bgunebakan/isimud/README.md

# Isimud
Sattellite modem control software and web application

# v2
Isimud v2 created with JAVA and Netbeans 8.0.2

# Libraries
 - Commons Cli 1.2
 - Pi4j
