bgunebakan/isimud/electronics/datasheets/simcard holder dimensions.jpg

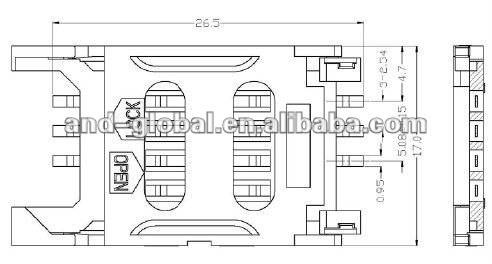
electronics/datasheets/simcard holder dimensions.jpg
