bgunebakan/isimud/electronics/datasheets/thuraya module.jpg

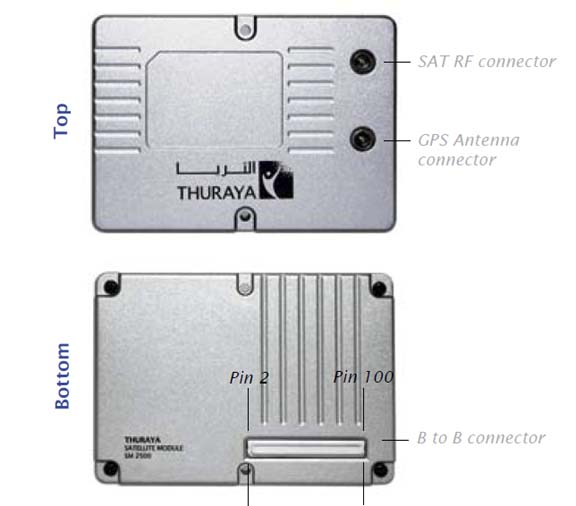
electronics/datasheets/thuraya module.jpg
