bgunebakan/isimud/screenshot/isimud_htop.png

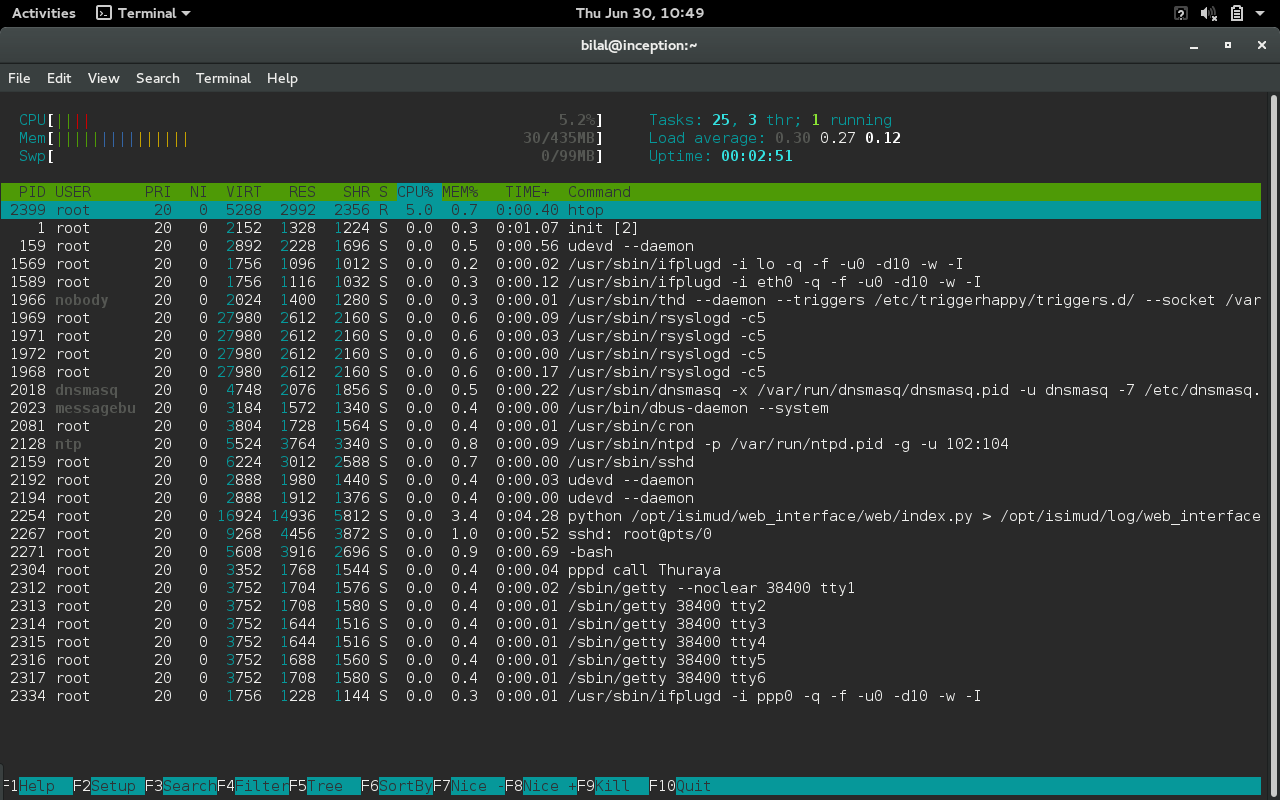
screenshot/isimud_htop.png
