bgunebakan/isimud/screenshot/isimud_web_interface.png

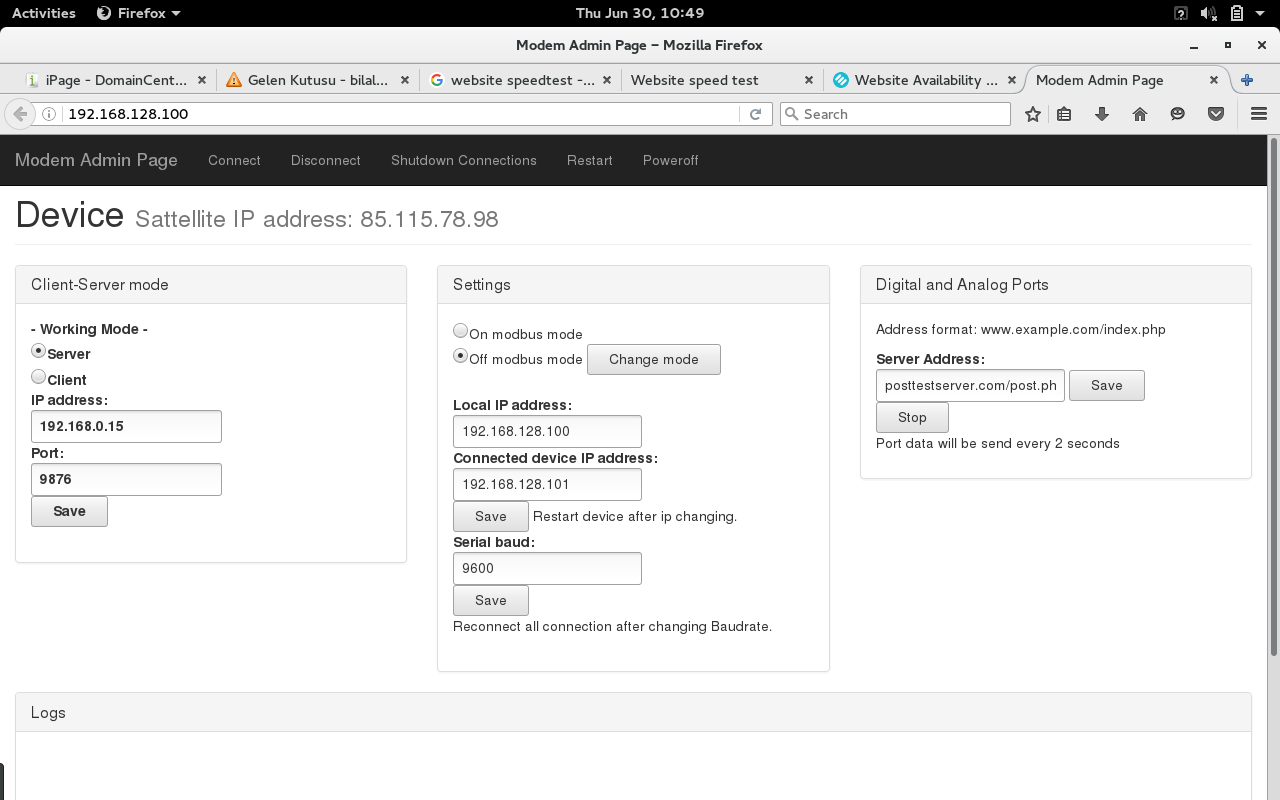
screenshot/isimud_web_interface.png
