bgunebakan/isimud/mechanics/Isimud.SLDASM

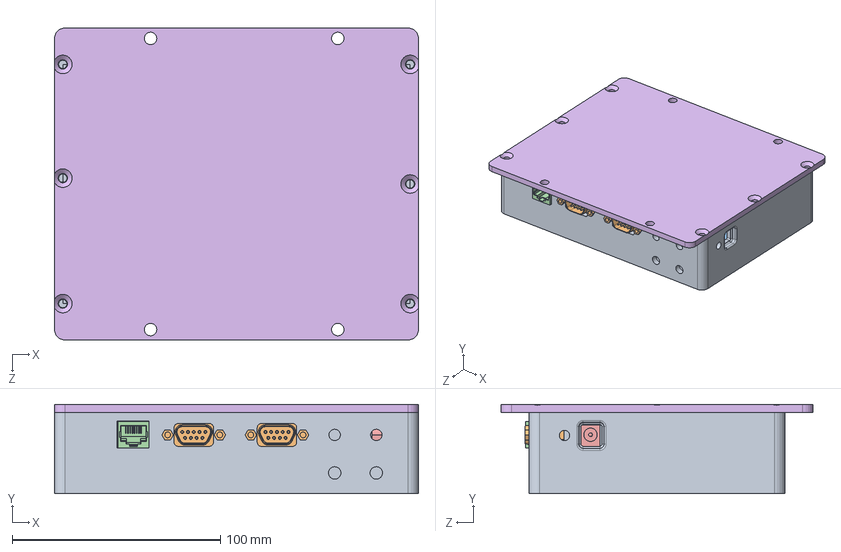
[picture p5: CAD file, 2016-08-03]
mechanics/Isimud.SLDASM
175.0 x 43.0 x 150.0 mm
bottom cover
DB9RA_M x 2
main board pcb
RJ-45
power jack
top cover
