bgunebakan/isimud/mechanics/electronics/main board pcb.SLDPRT

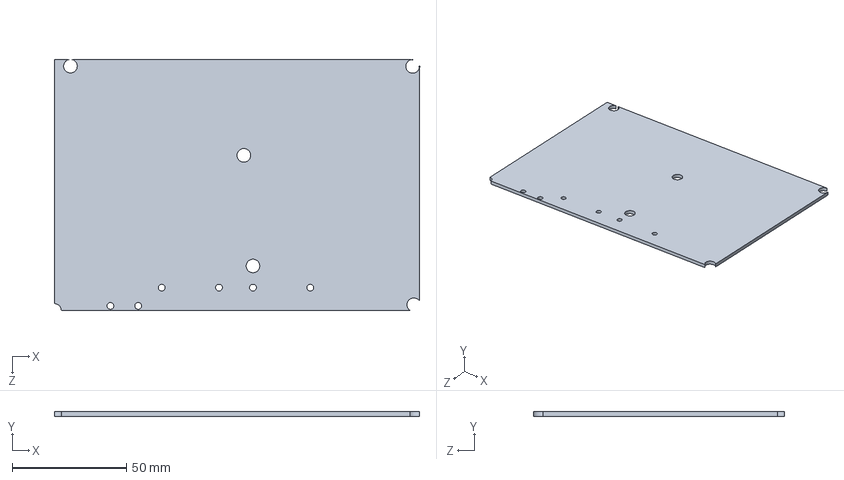
[picture p6: CAD file, 2016-07-28]
mechanics/electronics/main board pcb.SLDPRT
160.0 x 2.00 x 110.0 mm
