bgunebakan/isimud/mechanics/3d printed/top cover.SLDPRT

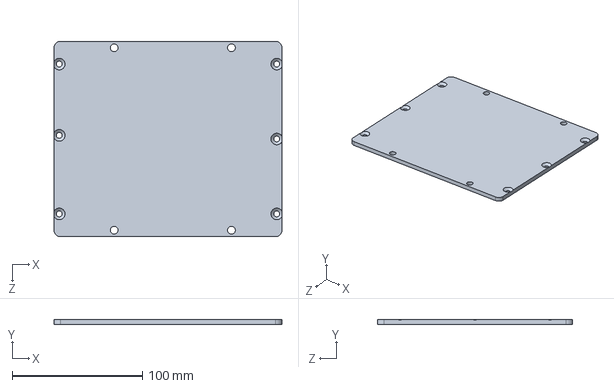
[picture p7: CAD file, 2016-08-03]
mechanics/3d printed/top cover.SLDPRT
175.0 x 4.00 x 150.0 mm
