bgunebakan/isimud/mechanics/electronics/RJ-45.SLDPRT

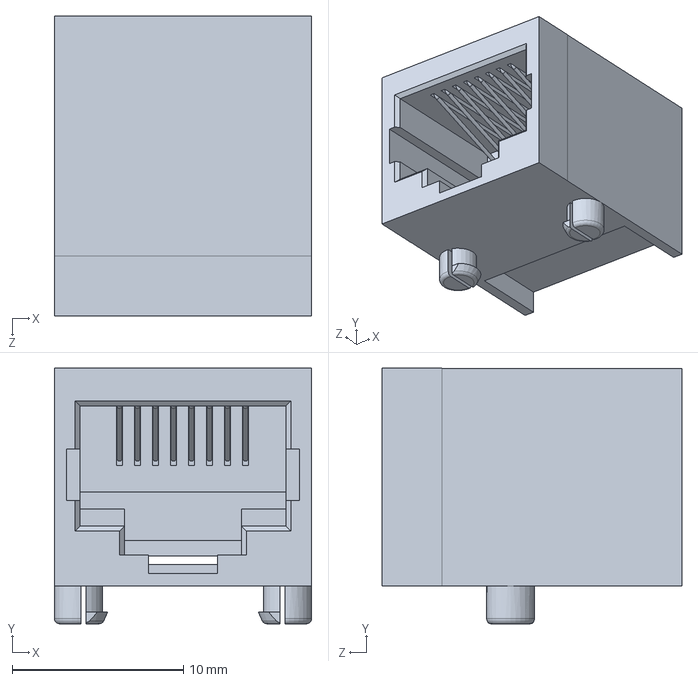
[picture p8: CAD file, 2016-07-28]
mechanics/electronics/RJ-45.SLDPRT
15.0 x 14.9 x 17.5 mm
