bgunebakan/isimud/mechanics/3d printed/bottom cover.SLDPRT

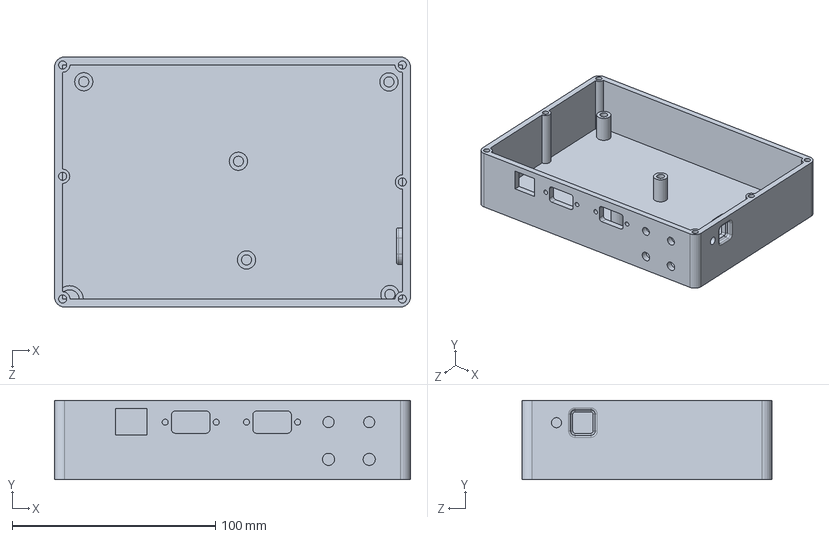
[picture p9: CAD file, 2016-07-28]
mechanics/3d printed/bottom cover.SLDPRT
175.0 x 39.0 x 123.0 mm
