bgunebakan/isimud/mechanics/electronics/DB9RA_M.SLDPRT

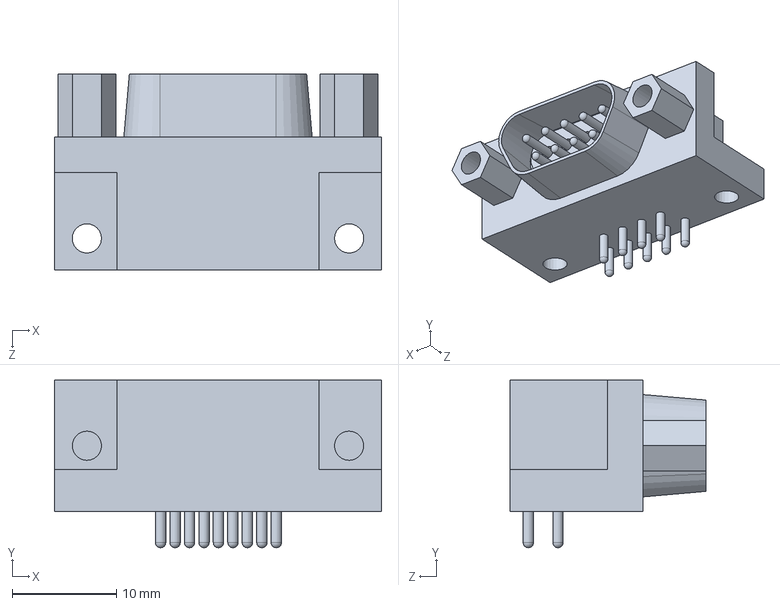
[picture p10: CAD file, 2016-07-28]
mechanics/electronics/DB9RA_M.SLDPRT
31.3 x 16.1 x 18.8 mm
