bgunebakan/isimud/mechanics/electronics/power jack.SLDPRT

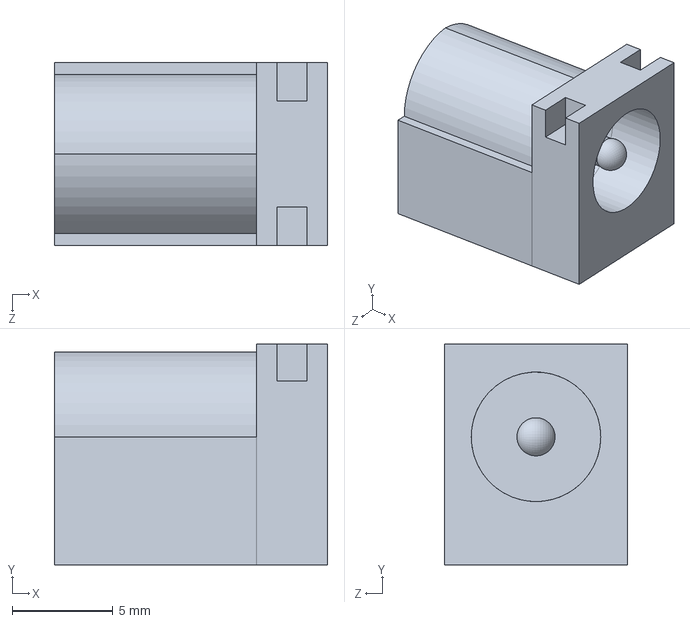
[picture p11: CAD file, 2016-07-28]
mechanics/electronics/power jack.SLDPRT
13.5 x 10.9 x 9.07 mm
