bgunebakan/isimud/(list of files, cad)

Other CAD files:
mechanics/3d printed/bottom cover.STL
mechanics/3d printed/top cover.STL
mechanics/electronics/RJ45.SLDPRT
