bgunebakan/isimud/(list of files, drawings)

Other design files:
electronics/datasheets/Scout/bll.DSN
electronics/datasheets/Scout/PHONE.LYT
electronics/gigabit ethernet/ext-ethernet.dsn
electronics/isimud_main/isimud_main.dsn
