bgunebakan/isimud/electronics/isimud_main/isimud_main.kicad_pcb

## KiCad design electronics/isimud_main/isimud_main.kicad_pcb (2017-01-13)

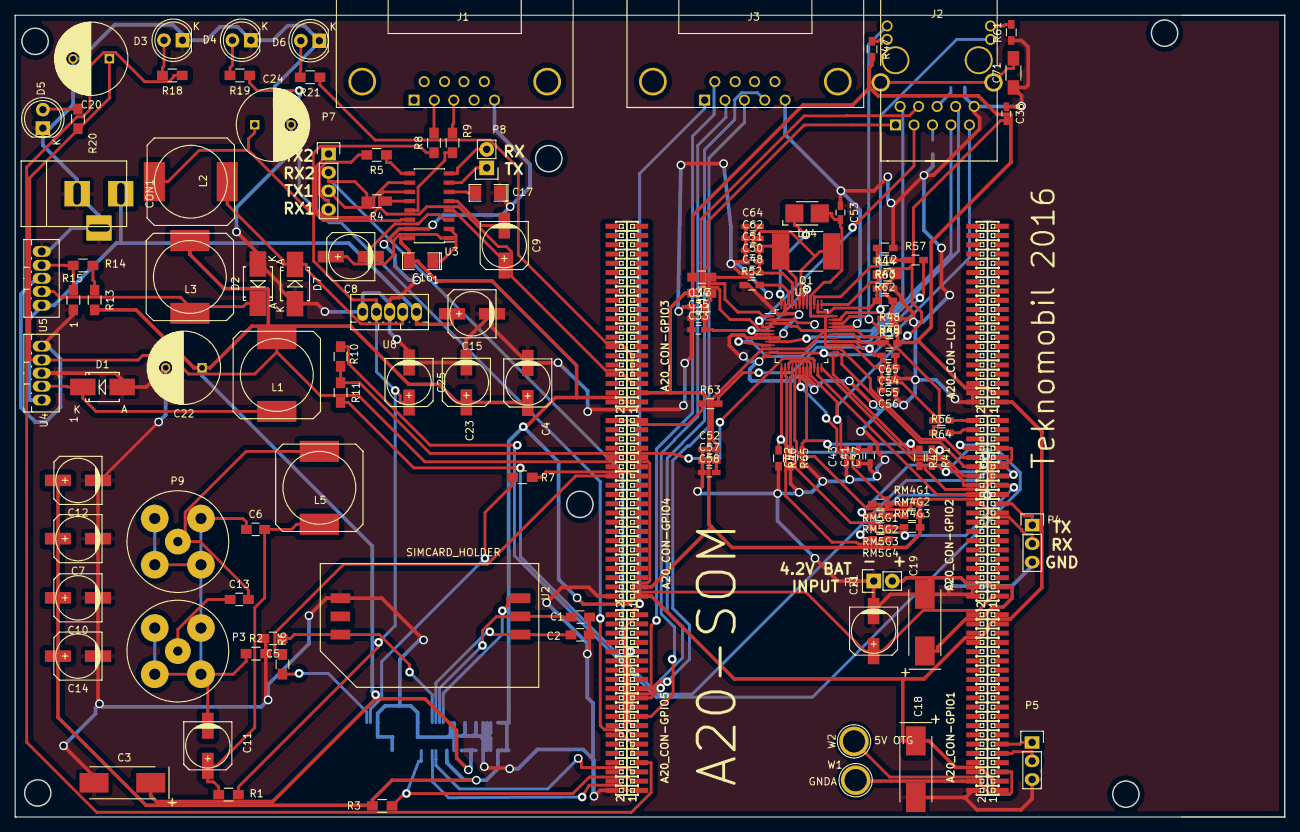
[picture p12: board isimud_main.kicad_pcb from above]

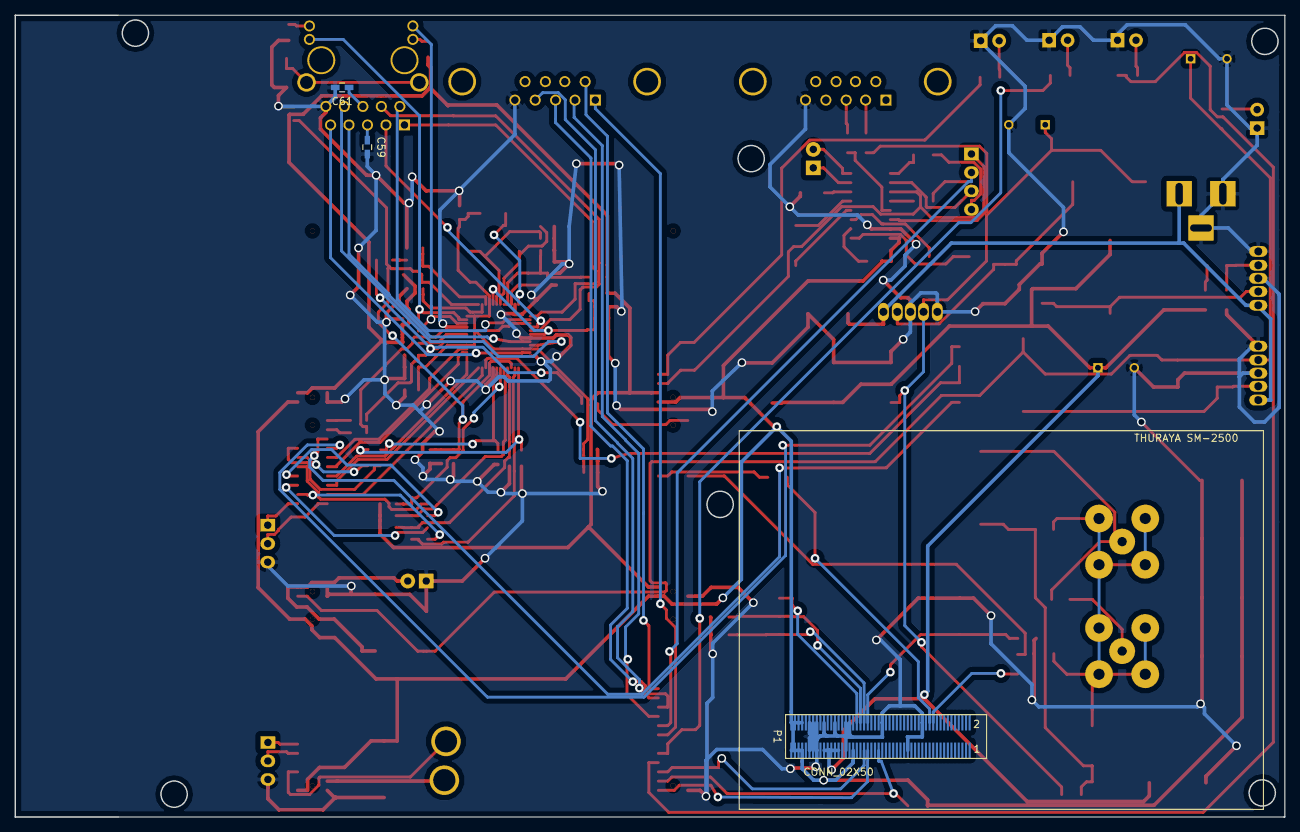
[picture p13: board isimud_main.kicad_pcb from below]

Board: 2 copper layers, 174.4 x 110.1 mm, 129 parts (3 on the bottom side), 115 nets.

Parts:
C1, C2, C5: 33pF; C_0805_HandSoldering
C3: 33uF 16V; TantalC_SizeD_EIA-7343_HandSoldering
C4: 1uF 16V; c_elec_6.3x5.8
C6, C13: 100nF; C_0805_HandSoldering
C7, C10, C11, C12, C14: 47uF 16V; c_elec_6.3x5.8
C8, C9: 1uF; c_elec_6.3x5.8
C15: 100uF; c_elec_6.3x5.8
C16, C17: 1uF; SMD-1206_Pol
C18: 10uF; TantalC_SizeD_EIA-7343_HandSoldering
C19: 22uF 6.3v; TantalC_SizeD_EIA-7343_HandSoldering
C20, C22, C24: 1000uF 16V; C_Radial_D10_L16_P5
C21, C23, C25: 220uF 16V; c_elec_6.3x5.8
C33, C37, C48, C52, C53: 22uF/6.3V; C_0603_HandSoldering
C34, C35, C38, C41, C43, C50, C51, C54, C55, C56, C57, C58, C59, C61: 100nF; C_0603_HandSoldering
C42, C65: NA; C_0603_HandSoldering
C62, C64: 27pF; C_0603_HandSoldering
C71: 1nF/2kV/X7R/1206; C_1206_HandSoldering
CON1: 12V DC; BARREL_JACK
D1, D2, D7: 1N5822; SMB_Handsoldering
D3: SAT_ON; LED-5MM
D4: GPS_ON; LED-5MM
D5: PWR_ON; LED-5MM
D6: STATUS; LED-5MM
J1, J3: DB9; DB9FC
J2: TM211Q01FM22
L1, L2, L3, L5: 100uH; SELF-WE-PD-XXL
L11, L12, L13: FB0805/600R/2A; C_0805_HandSoldering
L14: 4.7uH/1.15A/DCR<0.1R/CD43; Inductor_1212
P1: CONN_02X50; BB-2X50-SMD
P2: LIPO_BAT; Socket_Strip_Straight_1x02
P3: SAT MODULE GPS; bnc-ci
P4: UART_0; Pin_Header_Straight_1x03
P5: UART_4; Pin_Header_Straight_1x03
P7: RS232-UART; Pin_Header_Straight_1x04
P8: RS232-2; Pin_Header_Straight_1x02
P9: AKTIF GPS ANTEN; bnc-ci
Q1: E4SB25.000F20E15(25MHz/20pF/20ppm/5x3.2mm); C_2220_HandSoldering
R1, R2, R8, R9, R11: 0R; R_0805_HandSoldering
R3: 10k; R_0805_HandSoldering
R4, R5: 2k2; R_0805_HandSoldering
R6, R7: 330; R_0805_HandSoldering
R10: NA; R_0805_HandSoldering
R13, R14: 1k2; R_0805_HandSoldering
R15: 1k; R_0805_HandSoldering
R18, R19, R20, R21: 220R; R_0805_HandSoldering
R40: 10K; R_0603_HandSoldering
R41, R42, R66: 22R; R_0603_HandSoldering
R43: 10k; R_0603_HandSoldering
R44, R57, R60, R64: NA; R_0603_HandSoldering
R47, R49, R61: 1K; R_0603_HandSoldering
R48, R59, R62: 4K7; R_0603_HandSoldering
R52: 2.49k/1%; R_0603_HandSoldering
R63: 1k; R_0603_HandSoldering
R65: NA(4.7k); R_0603_HandSoldering
RM4G1, RM4G2, RM4G3: R; R_0603_HandSoldering
RM5G1, RM5G2, RM5G3, RM5G4: RA1206_(4X0603)_4B8_22R; R_0603_HandSoldering
U1: SOM-A20; A20-SOM
U2: SIMCARD_HOLDER; SIMCARD
U3: MAX232; SOIC-16_3.9x9.9mm_Pitch1.27mm
U4, U8: LM2576-5V; Pentawatt_Neutral_Straight_Vertical_TO220-5-T05A
U5: LM2576; Pentawatt_Neutral_Straight_Vertical_TO220-5-T05A
U7: RTL8211CL-GR; LQFP-48_7x7mm_Pitch0.5mm
W1: GNDA; 1pin
W2: 5V OTG; 1pin

Connections:
+3V3: L11.2, L12.2, L13.2, R47.2, R48.2, R49.2, R62.2, RM4G1.2, RM4G2.2, RM4G3.2, U1.3-3, U1.4-3, U1.6-3
+5V: C7.1, C10.1, C12.1, C14.1, C16.2, C18.1, P1.65, P1.93, P1.94, P1.95, P1.96, P1.97, P1.98, P1.99, P1.100, R3.2, U1.1-1, U1.3-1, U1.4-1, U1.6-1, U3.16
+5VD: C24.1, C25.1, L2.2, R1.2, U8.4
+6V: C3.1, C4.1, C22.1, C23.1, L3.2, P1.73, P1.75, P1.77, P1.79, P1.81, R13.2
+12V: C15.1, CON1.1, U4.1, U5.1, U8.1
+BATT: C19.1, P2.2, U1.2-3
/THURAYA_RX: P1.24, R7.2
/THURAYA_TX: P1.22, R6.2
CLK125: R66.2, U1.2-38
EMDIO: R49.1, U7.31
EPHY-RST#: R64.1, U1.2-40
ERXCK: R42.2, U1.2-33
ERXD0: RM5G4.2, U1.2-23
ERXD1: RM5G3.2, U1.2-25
ERXD2: RM5G2.2, U1.2-27
ERXD3: RM5G1.2, U1.2-29
ERXDV: R41.2, U1.2-31
ETXCK: R10.1, R11.1, U7.22
ETXD0: U1.2-24, U7.23
ETXD1: U1.2-26, U7.24
ETXD2: U1.2-28, U7.25
ETXD3: U1.2-30, U7.26
ETXEN: U1.2-32, U7.27
GND: C1.2, C2.2, C3.2, C4.2, C5.2, C7.2, C10.2, C12.2, C14.2, C15.2, C17.1, C18.2, C19.2, C20.2, C21.2, C22.2, C23.2, C24.2, C25.2, C33.1, C34.1, C35.1, C37.1, C38.1, C41.1, C42.1, C43.1, C48.1, C50.1, C51.1, C52.1, C53.1, C54.1, C55.1, C56.1, C57.1, C58.1, C59.2, C61.2, C62.1, C64.1, C65.1, C71.1, CON1.2, CON1.3, D1.2, D2.2, D3.1, D4.1, D5.1, D6.1, D7.2, J1.5, J2.10, J3.5, P1.28, P1.35, P1.50, P1.67, P1.68, P1.69, P1.70, P1.76, P1.82, P1.83, P1.85, P1.86, P1.87, P1.88, P1.89, P1.90, P1.91, P1.92, P2.1, P4.3, P5.3, R2.2, R15.1, R40.2, R44.1, R52.1, R59.1, R60.2, R61.1, R65.2, U1.1-2, U1.2-2, U1.2-4, U1.4-2, U1.5-2, U1.6-2, U1.6-4, U2.4, U3.15, U4.3, U4.5, U5.3, U5.5, U7.7, U7.12, U7.20, U7.33, U7.47, U8.3, U8.5
GNDA: U1.1-4, W1.1
GPS_LED: R19.1, U1.5-9
unnamed: C1.1, P1.62, U2.2
unnamed: C2.1, P1.60, U2.3
unnamed: C5.1, P1.58, U2.6
unnamed: C8.1, U3.1
unnamed: C8.2, U3.3
unnamed: C9.1, U3.4
unnamed: C9.2, U3.5
unnamed: C6.2, C11.1, L5.1, R1.1
unnamed: C6.1, C11.2, P3.2, P9.2, R2.1
unnamed: C13.1, P3.1
unnamed: C13.2, L5.2, P9.1
unnamed: C16.1, U3.2
unnamed: C17.2, U3.6
unnamed: C33.2, C34.2, C35.2, L11.1, U7.6, U7.41
unnamed: C37.2, C38.2, C41.2, C43.2, L12.1, U7.15, U7.21, U7.37
unnamed: C42.2, R42.1, U7.19
unnamed: C48.2, C50.2, C51.2, L13.1, U7.44, U7.45
unnamed: C52.2, C53.2, C54.2, C55.2, C56.2, C57.2, C58.2, L14.2, U7.3, U7.10, U7.28, U7.36, U7.40
unnamed: C59.1, J2.5
unnamed: C61.1, J2.6
unnamed: C62.2, Q1.1, U7.42
unnamed: C64.2, Q1.2, U7.43
unnamed: C65.2, R57.2, R63.2, R64.2, U7.29
unnamed: C71.2, J2.SH1, J2.SH2
unnamed: D1.1, L1.1, U4.2
unnamed: D2.1, L3.1, U5.2
unnamed: D3.2, R18.2
unnamed: D4.2, R19.2
unnamed: D5.2, R20.2
unnamed: D6.2, R21.2
unnamed: D7.1, L2.1, U8.2
unnamed: J1.2, R8.2
unnamed: J1.3, R9.2
unnamed: J2.1, U7.1
unnamed: J2.2, U7.2
unnamed: J2.3, U7.4
unnamed: J2.4, U7.5
unnamed: J2.7, U7.8
unnamed: J2.8, U7.9
unnamed: J2.9, U7.11
unnamed: J2.11, R59.2, U7.35
unnamed: J2.12, R61.2
unnamed: J2.13, R47.1
unnamed: J2.14, R48.1, U7.34
unnamed: L14.1, U7.48
unnamed: P1.64, U2.1
unnamed: P7.3, U3.10
unnamed: P7.4, R5.2
unnamed: P8.1, U3.7
unnamed: P8.2, U3.8
unnamed: R4.1, U3.12
unnamed: R5.1, U3.9
unnamed: R8.1, U3.14
unnamed: R9.1, U3.13
unnamed: R10.2, U1.2-34
unnamed: R11.2, U1.2-36
unnamed: R13.1, R14.1
unnamed: R14.2, R15.2, U5.4
unnamed: R40.1, R41.1, U7.13
unnamed: R43.1, R57.1
unnamed: R43.2, R44.2, U7.39
unnamed: R52.2, U7.46
unnamed: R60.1, R62.1, U7.38
unnamed: R65.1, RM4G3.1, RM5G3.1, U7.16
unnamed: R66.1, U7.32
unnamed: RM4G1.1, RM5G1.1, U7.18
unnamed: RM4G2.1, RM5G2.1, U7.17
unnamed: RM5G4.1, U7.14
unnamed: U1.1-5, W2.1
PG6: J3.1, U1.5-13
PG8: J3.2, U1.5-17
PG9: J3.3, U1.5-19
PG10: J3.4, U1.5-21
PG11: J3.6, U1.5-23
PWR_LED: C20.1, C21.1, L1.2, R20.1, U1.2-1, U4.4
RESET_N: R63.1, U1.4-40
SAT_LED: R18.1, U1.5-7
SAT_OFF: P1.59, U1.5-5
SAT_ON: P1.57, U1.5-1
SAT_RST: P1.51, R3.1, U1.5-3
STATUS_LED: R21.1, U1.3-7
UART0_RX: P4.2, U1.2-22
UART0_TX: P4.1, U1.2-21
UART3_RX: P7.2, R4.2, U1.5-15
UART3_TX: P7.1, U1.3-5, U3.11
UART4_RX: P5.2, U1.1-9
UART4_TX: P5.1, U1.1-11
UART6_RX: R6.1, U1.4-28
UART6_TX: R7.1, U1.4-27
