bgunebakan/isimud/electronics/gigabit ethernet/ext-ethernet.kicad_pcb

## KiCad design electronics/gigabit ethernet/ext-ethernet.kicad_pcb (2016-09-30)

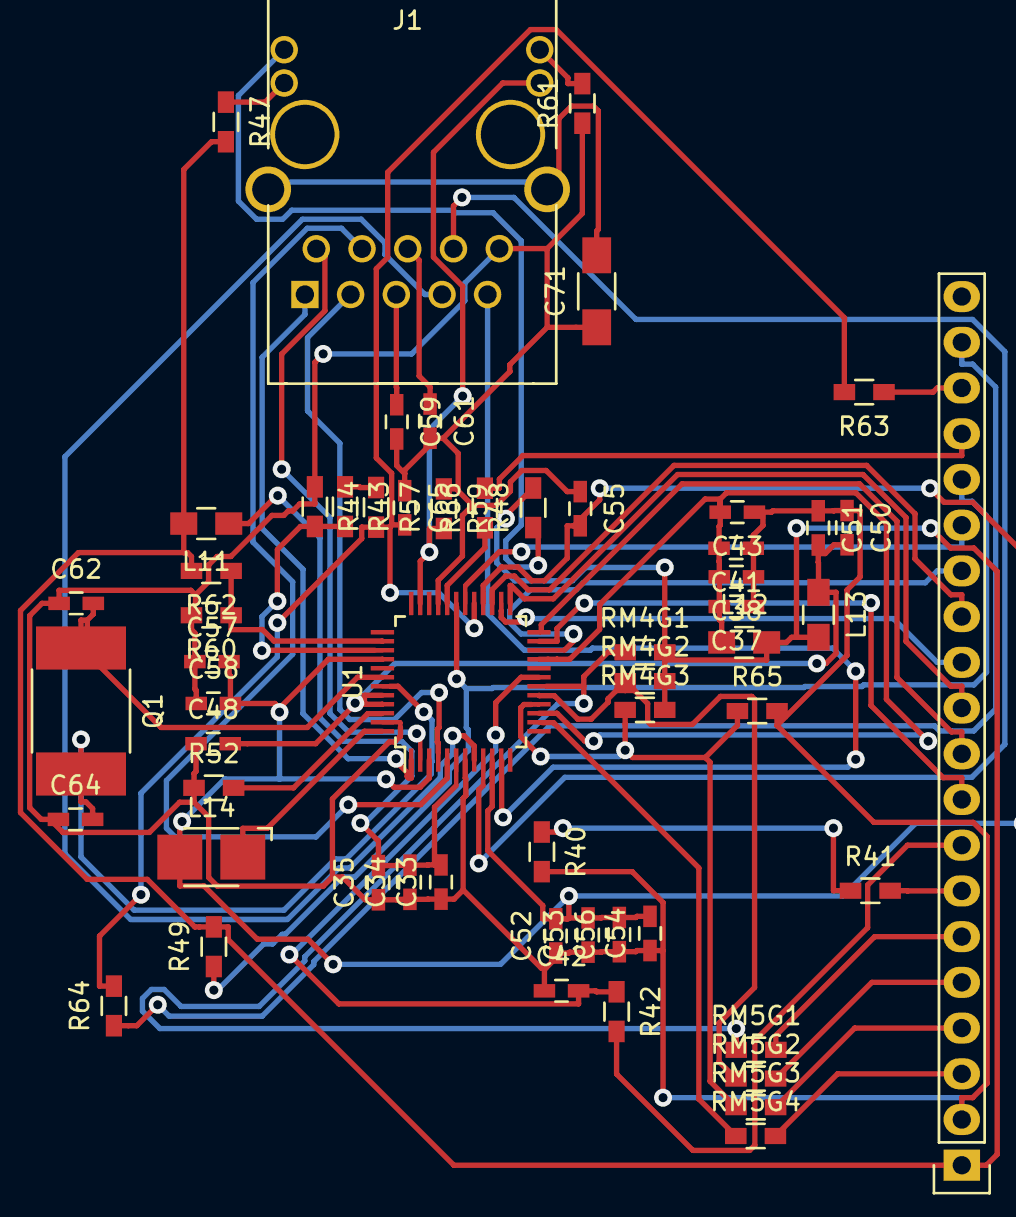
[picture p14: board ext-ethernet.kicad_pcb from above]

Board: 2 copper layers, 57 parts (0 on the bottom side), 52 nets.

Parts:
C33, C37, C48, C52, C53: 22uF/6.3V; C_0603_HandSoldering
C34, C35, C38, C41, C43, C50, C51, C54, C55, C56, C57, C58, C59, C61: 100nF; C_0603_HandSoldering
C42, C65: NA; C_0603_HandSoldering
C62, C64: 27pF; C_0603_HandSoldering
C71: 1nF/2kV/X7R/1206; C_1206_HandSoldering
J1: TM211Q01FM22
L11, L12, L13: FB0805/600R/2A; C_0805_HandSoldering
L14: 4.7uH/1.15A/DCR<0.1R/CD43; Inductor_1212
P1: CONN_01X20; Pin_Header_Straight_1x20
Q1: E4SB25.000F20E15(25MHz/20pF/20ppm/5x3.2mm); C_2220_HandSoldering
R40: 10K; R_0603_HandSoldering
R41, R42, R66: 22R; R_0603_HandSoldering
R43: 10k; R_0603_HandSoldering
R44, R57, R60, R64: NA; R_0603_HandSoldering
R47, R49, R61: 1K; R_0603_HandSoldering
R48, R59, R62: 4K7; R_0603_HandSoldering
R52: 2.49k/1%; R_0603_HandSoldering
R63: 1k; R_0603_HandSoldering
R65: NA(4.7k); R_0603_HandSoldering
RM4G1, RM4G2, RM4G3: R; R_0603_HandSoldering
RM5G1, RM5G2, RM5G3, RM5G4: RA1206_(4X0603)_4B8_22R; R_0603_HandSoldering
U1: RTL8211CL-GR; LQFP-48_7x7mm_Pitch0.5mm

Connections:
+3V3: L11.2, L12.2, L13.2, P1.1, R47.2, R48.2, R49.2, R62.2, RM4G1.2, RM4G2.2, RM4G3.2
GND: C33.1, C34.1, C35.1, C37.1, C38.1, C41.1, C42.1, C43.1, C48.1, C50.1, C51.1, C52.1, C53.1, C54.1, C55.1, C56.1, C57.1, C58.1, C59.2, C61.2, C62.1, C64.1, C65.1, C71.1, J1.10, P1.2, R40.2, R44.1, R52.1, R59.1, R60.2, R61.1, R65.2, U1.7, U1.12, U1.20, U1.33, U1.47
unnamed: C33.2, C34.2, C35.2, L11.1, U1.6, U1.41
unnamed: C37.2, C38.2, C41.2, C43.2, L12.1, U1.15, U1.21, U1.37
unnamed: C42.2, R42.1, U1.19
unnamed: C48.2, C50.2, C51.2, L13.1, U1.44, U1.45
unnamed: C52.2, C53.2, C54.2, C55.2, C56.2, C57.2, C58.2, L14.2, U1.3, U1.10, U1.28, U1.36, U1.40
unnamed: C59.1, J1.5
unnamed: C61.1, J1.6
unnamed: C62.2, Q1.1, U1.42
unnamed: C64.2, Q1.2, U1.43
unnamed: C65.2, R57.2, R63.2, R64.2, U1.29
unnamed: C71.2, J1.SH1, J1.SH2
unnamed: J1.1, U1.1
unnamed: J1.2, U1.2
unnamed: J1.3, U1.4
unnamed: J1.4, U1.5
unnamed: J1.7, U1.8
unnamed: J1.8, U1.9
unnamed: J1.9, U1.11
unnamed: J1.11, R59.2, U1.35
unnamed: J1.12, R61.2
unnamed: J1.13, R47.1
unnamed: J1.14, R48.1, U1.34
unnamed: L14.1, U1.48
unnamed: P1.3, RM5G4.2
unnamed: P1.4, RM5G3.2
unnamed: P1.5, RM5G2.2
unnamed: P1.6, RM5G1.2
unnamed: P1.7, R41.2
unnamed: P1.8, R42.2
unnamed: P1.9, U1.23
unnamed: P1.10, U1.24
unnamed: P1.11, U1.25
unnamed: P1.12, U1.26
unnamed: P1.13, U1.27
unnamed: P1.14, U1.22
unnamed: P1.15, U1.30
unnamed: P1.16, R49.1, U1.31
unnamed: P1.17, R66.2
unnamed: P1.18, R63.1
unnamed: P1.19, R64.1
unnamed: R40.1, R41.1, U1.13
unnamed: R43.1, R57.1
unnamed: R43.2, R44.2, U1.39
unnamed: R52.2, U1.46
unnamed: R60.1, R62.1, U1.38
unnamed: R65.1, RM4G3.1, RM5G3.1, U1.16
unnamed: R66.1, U1.32
unnamed: RM4G1.1, RM5G1.1, U1.18
unnamed: RM4G2.1, RM5G2.1, U1.17
unnamed: RM5G4.1, U1.14
