bgunebakan/isimud/software/isimud_v2/Isimud/src/isimud/Main.java

/*
 * Copyright (C) 2015 Bilal Tonga
 *
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
 * You should have received a copy of the GNU General Public License
 * along with this program; if not, write to the Free Software
 * Foundation, Inc., 59 Temple Place - Suite 330, Boston, MA  02111-1307, USA.
 */
package isimud;

/**
 *
 * @author gunebakan
 */
public class Main {

    /**
     * @param args the command line arguments
     */
    
    Config config = new Config();
    
    
    
    
    
    public static void main(String[] args) throws Exception {
        new Cli(args).parse();
        
        //tcp.startServer("123");
        //tcp.sendPost("http://ufakisler.net","lang=eng");
        
        
        
        
    }
    
}
