bgunebakan/isimud/software/isimud_v2/Isimud/src/isimud/Serial.java

/*
 * Copyright (C) 2015 gunebakan
 *
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
 * You should have received a copy of the GNU General Public License
 * along with this program; if not, write to the Free Software
 * Foundation, Inc., 59 Temple Place - Suite 330, Boston, MA  02111-1307, USA.
 */
package isimud;

import com.pi4j.io.serial.SerialPortException;
import java.util.Arrays;
import java.util.logging.Level;
import java.util.logging.Logger;
import jssc.SerialPort;
import jssc.SerialPortEvent;
import jssc.SerialPortEventListener;

/**
 *
 * @author gunebakan
 */
public class Serial {
    
    static SerialPort serialPort;
    String readSerialData;
    boolean bufferFull = false;
    
    Config config = new Config();
  // Tcp tcp = new Tcp();
    
    public void initSerial(){
        serialPort = new SerialPort(config.serial_port);
        
        try {
            System.out.println("Port opened: " + serialPort.openPort());
            System.out.println("Params setted: " + serialPort.setParams(9600, 8, 1, 0));
            
        }
        catch (SerialPortException ex){
            System.out.println(ex);
        } catch (jssc.SerialPortException ex) {
            Logger.getLogger(Serial.class.getName()).log(Level.SEVERE, null, ex);
        }

    }
    public void writeSerial(String data){
        
        try {
            System.out.println(data);
            serialPort.writeString(data);
            
        } catch (jssc.SerialPortException ex) {
            Logger.getLogger(Serial.class.getName()).log(Level.SEVERE, null, ex);
        }
        
    }
    
    public void readSerial(){
        
        int mask = SerialPort.MASK_RXCHAR;// + SerialPort.MASK_CTS + SerialPort.MASK_DSR;//Prepare mask
        
        try {
            
            serialPort.setEventsMask(mask);//Set mask
            serialPort.addEventListener(new SerialPortReader());//Add SerialPortEventListener
            
        } catch (jssc.SerialPortException ex) {
            Logger.getLogger(Serial.class.getName()).log(Level.SEVERE, null, ex);
        }
    
    }
    public void closePort(){
        
        try {
            System.out.println("Port closed: " + serialPort.closePort());
        } catch (jssc.SerialPortException ex) {
            Logger.getLogger(Serial.class.getName()).log(Level.SEVERE, null, ex);
        }
        
    }
    
    public String readData(){
        String Data = "";
        try {
            Data = serialPort.readString();
        } catch (jssc.SerialPortException ex) {
            Logger.getLogger(Serial.class.getName()).log(Level.SEVERE, null, ex);
        }
        System.out.print(Data);
        return Data;
    }
    
    /*
     * In this class must implement the method serialEvent, through it we learn about 
     * events that happened to our port. But we will not report on all events but only 
     * those that we put in the mask. In this case the arrival of the data and change the 
     * status lines CTS and DSR
     */
    class SerialPortReader implements SerialPortEventListener {
        String data = "";
        int i =0;
        @Override
        public void serialEvent(SerialPortEvent event) {
            
            
            
            if(event.isRXCHAR()){//If data is available
                if(true){//Check bytes count in the input buffer
                    //Read data, if 10 bytes available 
                    try {
                        
                        data = serialPort.readString(1);
                        readSerialData += data;
                        
                        if(!data.equals("\n")){
                            bufferFull = false;
                        }else{
                            if(config.modbus_mode){
                                
                            }
                            bufferFull = true;
                            Thread.sleep(500);
                            readSerialData = "";
                        }
                        
                        
                    }
                    catch (SerialPortException ex) {
                        System.out.println(ex);
                    } catch (jssc.SerialPortException ex) {
                        Logger.getLogger(Serial.class.getName()).log(Level.SEVERE, null, ex);
                    } catch (InterruptedException ex) {
                        Logger.getLogger(Serial.class.getName()).log(Level.SEVERE, null, ex);
                    }
                }
            }
          
        }
    }


    
    
}
