bgunebakan/isimud/(commit log)

2016-07-17 lots of datasheet and main board schematics
    [PHONE.LYT, bll.DSN, isimud_main.kicad_pcb, isimud_main.sch]
2016-07-20 parts placed on print board
    [isimud_main.dsn, isimud_main.kicad_pcb, isimud_main.sch]
2016-07-24 pcb design is done,last checks for gerber
    [isimud_main.csv, isimud_main.dsn, isimud_main.kicad_pcb, isimud_main.sch]
2016-07-26 new revision for production
    [isimud_main.kicad_pcb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]
2016-07-28 pcb rev.a produced,mechanics design has began
    [isimud_main-B.Adhes.gbr, isimud_main-B.CrtYd.gbr, isimud_main-B.Cu.gbr, isimud_main-B.Fab.gbr, isimud_main-B.Mask.gbr, isimud_main-B.Paste.gbr, isimud_main-B.SilkS.gbr, isimud_main-Cmts.User.gbr]
2016-07-28 mechanic design is not finished
    [DB9RA_M.SLDPRT, Isimud.SLDASM, RJ-45.SLDPRT, RJ45.SLDPRT, bottom cover.SLDPRT, bottom cover.STL, main board pcb.SLDPRT, power jack.SLDPRT]
2016-07-30 box design is finished
    [Isimud.SLDASM, top cover.SLDPRT, top cover.STL]
2016-08-03 test 0.1
    [isimud_main.csv, isimud_main.kicad_pcb, isimud_main.sch, isimud_main_BOM.csv]
2016-09-24 REV1.A is done but enc28j60 is not working,go next revision
    [isimud_main.kicad_pcb, isimud_main.sch]
2016-09-30 moving to revision 2
    [ext-ethernet.dsn, ext-ethernet.kicad_pcb, ext-ethernet.sch]
2016-09-30 shematics is done,pcb routing started
    [ext-ethernet.sch, isimud_main.kicad_pcb, isimud_main.sch]
2017-01-13 thuraya datasheets
    [A13-SOM-WIFI_Rev_B.brd, A13-SOM-WIFI_Rev_B.sch, isimud_main.dsn, isimud_main.kicad_pcb, isimud_main.sch]
