bgunebakan/isimud/(notices)

Notices in the files:
software/isimud_v2/Isimud/src/isimud/Cli.java:
modify it under the terms of the GNU General Public License
